ffxx68/Sharp_ce140f_emul/KiCad_v2/Litio_523450.step

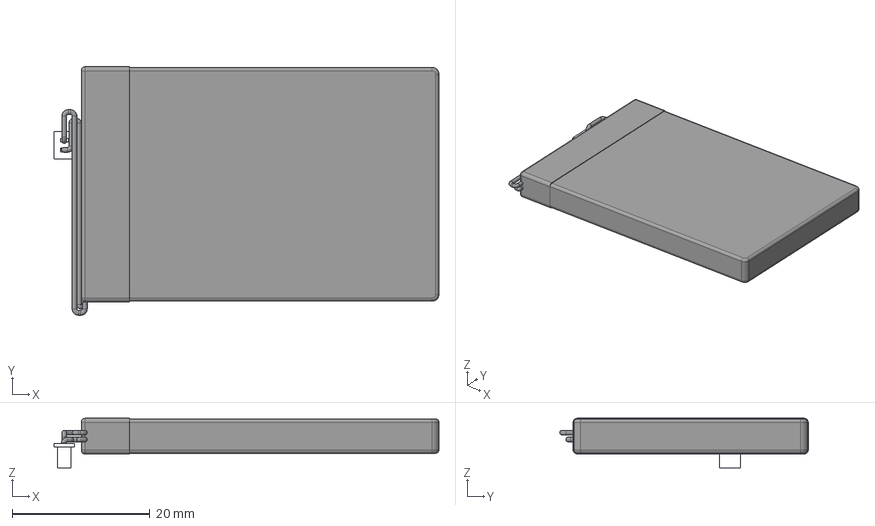
[picture p1: CAD file, 2026-08-25]
KiCad_v2/Litio_523450.step
56.0 x 36.2 x 7.20 mm
Conector
