ffxx68/Sharp_ce140f_emul/KiCad_v2/SD_molex_104031-0811/Molex_104031-0811.stp

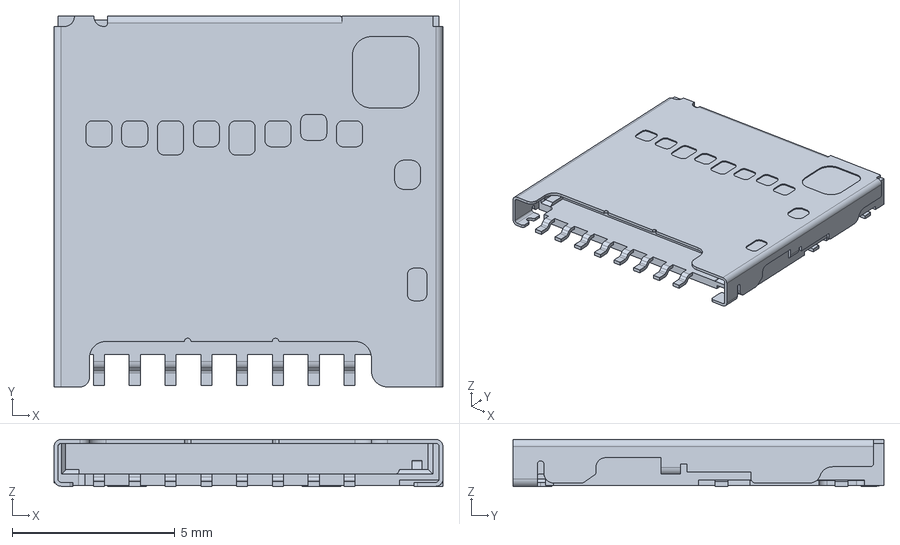
[picture p2: CAD file, 2026-08-25]
KiCad_v2/SD_molex_104031-0811/Molex_104031-0811.stp
11.9 x 11.4 x 1.45 mm
