ffxx68/Sharp_ce140f_emul/KiCad_v1/button/SW_PUSH_6mm.step

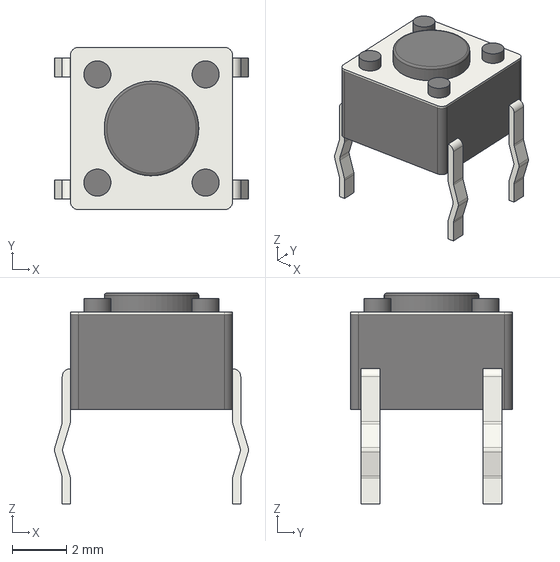
[picture p3: CAD file, 2026-08-25, an earlier design]
KiCad_v1/button/SW_PUSH_6mm.step
7.17 x 6.00 x 7.80 mm
