ffxx68/Sharp_ce140f_emul/(list of files, drawings)

Other design files:
Board_v1.5_PoyokomaDanna/CE-140F_emu11_GP.dip
KiCad_v1/sharp-ce140f-emul_v1.dsn
KiCad_v2/sharp-ce140f-emul_v2.dsn
