ffxx68/Sharp_ce140f_emul/KiCad_v1/sharp-ce140f-emul_v1.kicad_pcb

## KiCad design KiCad_v1/sharp-ce140f-emul_v1.kicad_pcb (2026-08-25, an earlier design)

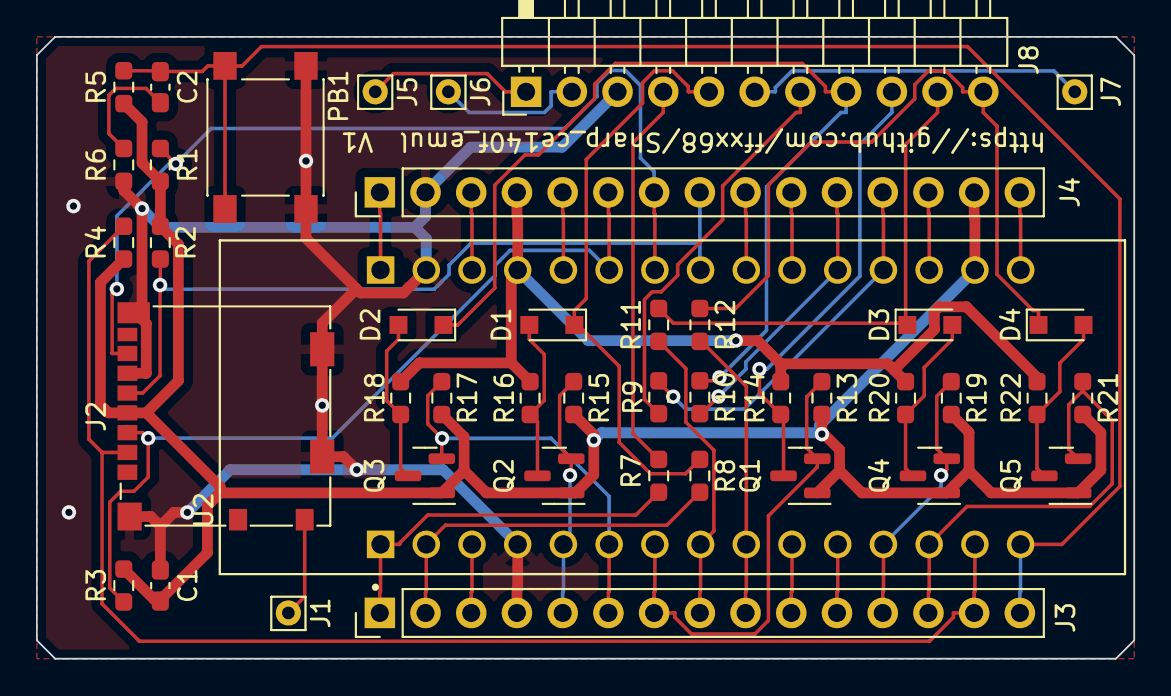
[picture p6: board sharp-ce140f-emul_v1.kicad_pcb from above]

Board: 2 copper layers, 61.0 x 34.5 mm, 43 parts (0 on the bottom side), 45 nets.

Parts:
C1, C2: 100n; C_0603_1608Metric_Pad1.08x0.95mm_HandSolder
D1, D2, D3, D4: 1N4148; D_SOD-323_HandSoldering
J1, J5, J6, J7: Conn_01x01; Pin_D0.7mm_L6.5mm_W1.8mm_FlatFork
J2: Micro_SD_Card_Det; microSD_HC_Molex_104031-0811
J3, J4: Conn_01x15; PinHeader_1x15_P2.54mm_Vertical
J8: Sharp PC 11-pin; PinHeader_1x11_P2.54mm_Horizontal
PB1: User_button; SW_Push_1P1T_NO_6x6mm_H9.5mm
Q1, Q2, Q3, Q4, Q5: BSS138; SOT-23
R1, R2, R3, R4, R5: 47k; R_0603_1608Metric_Pad0.98x0.95mm_HandSolder
R6: 100; R_0603_1608Metric_Pad0.98x0.95mm_HandSolder
R7, R8, R9, R10, R11, R12, R13, R15, R17, R19, R21: 10k; R_0603_1608Metric_Pad0.98x0.95mm_HandSolder
R14, R16, R18, R20, R22: 5k; R_0603_1608Metric_Pad0.98x0.95mm_HandSolder
U2: NUCLEO-L432KC; MODULE_NUCLEO-L432KC

Connections:
+3V3: C1.1, J2.4 (VDD), J4.14, Q1.1 (G), Q2.1 (G), Q3.1 (G), Q4.1 (G), Q5.1 (G), R1.1, R2.1, R3.1, R4.1, R5.2, R13.2, R15.2, R17.2, R19.2, R21.2, U2.CN4_14 (+3V3)
+5V: J4.4, R14.2, R16.2, R18.2, R20.2, R22.2, U2.CN4_4 (+5V)
/Level Conv2/conv_HV: D1.2 (A), Q2.3 (D), R16.1
/Level Conv3/conv_HV: D2.2 (A), Q3.3 (D), R18.1
/Level Conv4/conv_HV: D3.2 (A), Q4.3 (D), R20.1
/Level Conv5/conv_HV: D4.2 (A), Q5.3 (D), R22.1
/conn_ack: J8.9 (ACK), Q1.3 (D), R14.1
/conn_busy: J8.4 (BUSY), R7.1
/conn_din: D2.1 (K), J8.8 (DIN), R10.1
/conn_dout: D1.1 (K), J8.5 (DOUT), R8.1
/conn_mtout2: J5.1, J8.1 (MT_OUT2)
/conn_sel1: D4.1 (K), J8.11 (SEL1), R12.1
/conn_sel2: D3.1 (K), J8.10 (SEL2), R11.1
/conn_vgg: J6.1, J8.2 (VGG)
/conn_xin: J7.1, J8.6 (X_IN)
/conn_xout: J8.7 (X_OUT), R9.1
/rc_btn: C2.2, R6.2
/sd_cd: J1.1, J2.10 (DET_A)
CN3_1: J3.1, R7.2, U2.CN3_1 (PA9)
CN3_2: J3.2, R8.2, U2.CN3_2 (PA10)
CN3_3: J3.3, U2.CN3_3 (NRST_CN3)
CN3_5: J3.5, Q2.2 (S), R15.1, U2.CN3_5 (PA12)
CN3_6: J3.6, Q3.2 (S), R17.1, U2.CN3_6 (PB0)
CN3_7: J3.7, Q1.2 (S), R13.1, U2.CN3_7 (PB7)
CN3_8: J3.8, R11.2, U2.CN3_8 (PB6)
CN3_9: J3.9, R12.2, U2.CN3_9 (PB1)
CN3_10: J3.10, U2.CN3_10 (D7)
CN3_11: J3.11, U2.CN3_11 (D8)
CN3_12: J3.12, Q4.2 (S), R19.1, U2.CN3_12 (PA8)
CN3_13: J3.13, Q5.2 (S), R21.1, U2.CN3_13 (PA11)
CN3_14: J2.2 (DAT3/CD), J3.14, R4.2, U2.CN3_14 (PB5)
CN3_15: C2.1, J3.15, PB1.1, R5.1, U2.CN3_15 (PB4)
CN4_1: J4.1, U2.CN4_1 (VIN)
CN4_3: J4.3, U2.CN4_3 (NRST_CN4)
CN4_5: J4.5, U2.CN4_5 (PA2)
CN4_6: J2.3 (CMD), J4.6, R3.2, U2.CN4_6 (PA7)
CN4_7: J2.7 (DAT0), J4.7, R1.2, U2.CN4_7 (PA6)
CN4_8: J2.5 (CLK), J4.8, R2.2, U2.CN4_8 (PA5)
CN4_9: J4.9, U2.CN4_9 (PA4)
CN4_10: J4.10, U2.CN4_10 (PA3)
CN4_11: J4.11, R10.2, U2.CN4_11 (PA1)
CN4_12: J4.12, R9.2, U2.CN4_12 (PA0)
CN4_13: J4.13, U2.CN4_13 (AREF)
CN4_15: J4.15, U2.CN4_15 (PB3)
GND: C1.2, J2.6 (VSS), J2.11 (SHIELD), J3.4, J4.2, J8.3 (GND), PB1.2, R6.1, U2.CN3_4 (GND_CN3), U2.CN4_2 (GND_CN4)
