ffxx68/Sharp_ce140f_emul/KiCad_v2/sharp-ce140f-emul_v2.kicad_pcb

## KiCad design KiCad_v2/sharp-ce140f-emul_v2.kicad_pcb (2026-08-25)

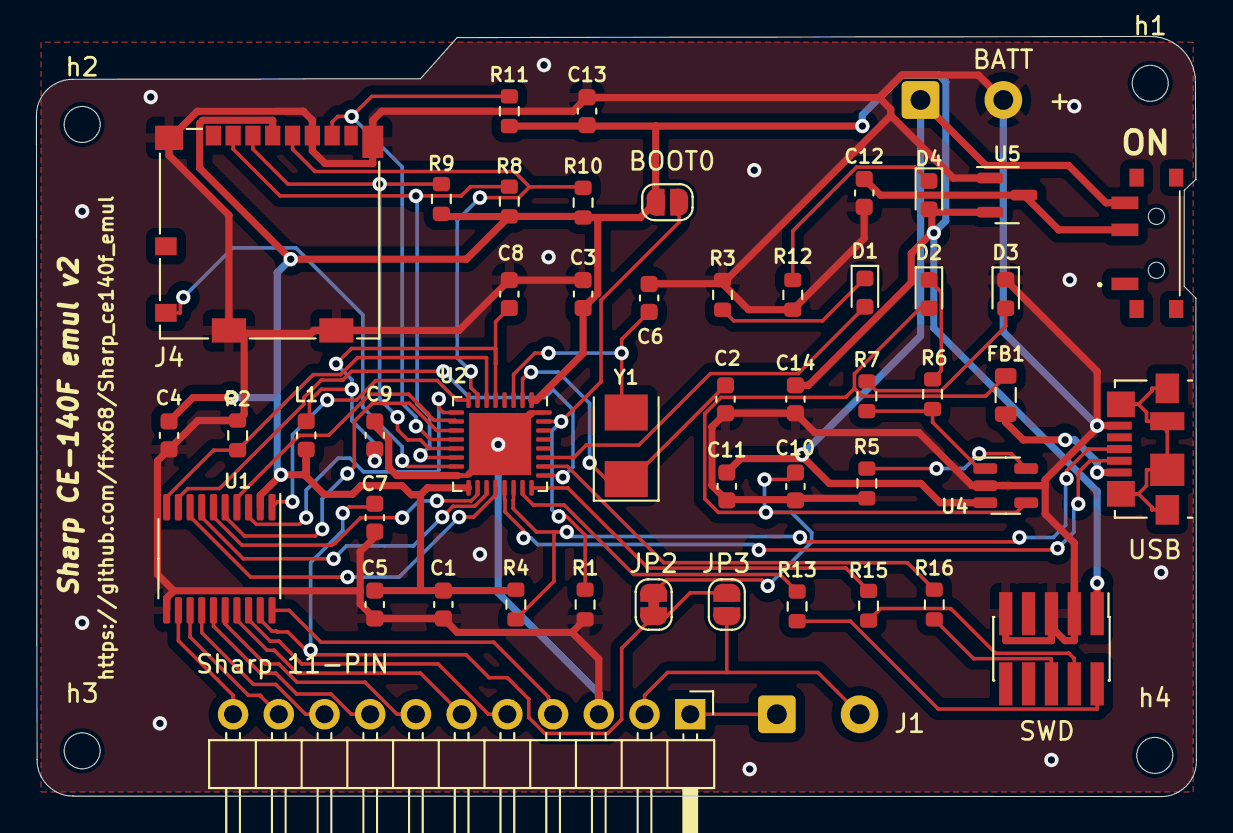
[picture p7: board sharp-ce140f-emul_v2.kicad_pcb from above]

Board: 2 copper layers, 64.4 x 42.2 mm, 54 parts (0 on the bottom side), 50 nets.

Parts:
BATT: Battery; SolderWire-0.5sqmm_1x02_P4.6mm_D0.9mm_OD2.1mm
BOOT0: BOOT0; SolderJumper-2_P1.3mm_Open_RoundedPad1.0x1.5mm
C1, C10, C11: 4u7; C_0603_1608Metric
C2, C6: 10p; C_0603_1608Metric
C3, C4, C5, C7, C9, C13: 100n; C_0603_1608Metric
C8, C12, C14: 1u; C_0603_1608Metric
D1: green; LED_0603_1608Metric
D2, D3: Blue; LED_0603_1608Metric
D4: red; LED_0603_1608Metric
FB1: 100R; L_0805_2012Metric
J1: ext pins; SolderWire-0.5sqmm_1x02_P4.6mm_D0.9mm_OD2.1mm
J4: Micro_SD_Card_Det; microSD_HC_Molex_104031-0811
JP2: 5V_VPP; SolderJumper-2_P1.3mm_Bridged_RoundedPad1.0x1.5mm
JP3: 5V_VGG; SolderJumper-2_P1.3mm_Open_RoundedPad1.0x1.5mm
L1: 27n; L_0603_1608Metric
ON: PCM12SMTR
R1, R5: 10k; R_0603_1608Metric
R2, R3, R4, R12: 1k5; R_0603_1608Metric
R6, R7: 2K2; R_0603_1608Metric
R8, R9, R10, R11: 47k; R_0603_1608Metric
R13, R15, R16: 22; R_0603_1608Metric
SWD: SWD; PinHeader_2x05_P1.27mm_Vertical_SMD
Sharp 11-PIN: Sharp PC 11-pin; PinHeader_1x11_P2.54mm_Horizontal
U1: TXS0108EPW; TSSOP-20_4.4x6.5mm_P0.65mm
U2: STM32L432KCUx; QFN-32-1EP_5x5mm_P0.5mm_EP3.45x3.45mm
U4: MCP73831; SOT-23-5
U5: XC6206P332MR; SOT-23
USB: USB_B_Micro; USB_Micro-B_Molex_47346-0001
Y1: 32.768KHz; Crystal_SMD_5032-2Pin_5.0x3.2mm
h1, h2, h3, h4: MountingHole_2mm

Connections:
+3.3VA: C8.1, C9.1, L1.2, U2.5 (VDDA)
+3V3: BOOT0.2 (B), C1.1, C3.1, C4.1, C5.1, C13.1, C14.1, D4.2 (A), J4.4 (VDD), L1.1, R4.1, R8.1, R9.1, R10.1, R11.1, SWD.1, U1.2 (VCCA), U2.1 (VDD), U2.17 (VDD), U5.2 (VO)
+5V: FB1.2, USB.1 (VBUS)
/BOOT0: BOOT0.1 (A), R1.1, U2.31 (PH3)
/HSE_IN: C2.1, U2.2 (PC14), Y1.1
/HSE_OUT: C6.1, U2.3 (PC15), Y1.2
/V_BAT: BATT.1, C11.1, ON.3 (NO), U4.3 (VBAT)
/ack: Sharp 11-PIN.9 (ACK), U1.14 (B6)
/busy: Sharp 11-PIN.4 (BUSY), U1.20 (B1)
/din: Sharp 11-PIN.8 (DIN), U1.15 (B5)
/dout: Sharp 11-PIN.5 (DOUT), U1.18 (B2)
/mt_out2: J1.1, Sharp 11-PIN.1 (MT_OUT2)
/sel1: Sharp 11-PIN.11 (SEL1), U1.12 (B8)
/sel2: Sharp 11-PIN.10 (SEL2), U1.13 (B7)
/usr_led: D1.2 (A), U2.27 (PB4)
/vccb: C7.1, JP2.1 (A), JP3.1 (A), U1.19 (VCCB)
/vgg: J1.2, JP3.2 (B), Sharp 11-PIN.2 (VGG)
/x_in: Sharp 11-PIN.6 (X_IN), U1.17 (B3)
/x_out: Sharp 11-PIN.7 (X_OUT), U1.16 (B4)
GND: BATT.2, C1.2, C2.2, C3.2, C4.2, C5.2, C6.2, C7.2, C8.2, C9.2, C10.2, C11.2, C12.2, C13.2, C14.2, D3.1 (K), J4.6 (VSS), J4.11 (SHIELD), R1.2, R2.1, R3.2, R5.2, R12.2, SWD.3, SWD.5, SWD.9, Sharp 11-PIN.3 (GND), U1.11 (GND), U2.16 (VSS), U2.32 (VSS), U2.33 (VSS), U4.2 (VSS), U5.1 (GND), USB.5 (GND)
unnamed: D1.1 (K), R3.1
unnamed: D2.1 (K), R6.1
unnamed: D3.2 (A), R7.1
unnamed: D4.1 (K), R12.1
unnamed: R13.2, SWD.2
unnamed: R15.2, SWD.4
unnamed: R16.2, SWD.6
unnamed: R5.1, U4.5 (PROG)
unnamed: R6.2, R7.2, U4.1 (STAT)
PA0: R2.2, U1.10 (OE), U2.6 (PA0)
PA2: U1.1 (A1), U2.8 (PA2)
PA3: U1.3 (A2), U2.9 (PA3)
PA4: U1.4 (A3), U2.10 (PA4)
PA5: U1.5 (A4), U2.11 (PA5)
PA8: U1.6 (A5), U2.18 (PA8)
PA9: U1.7 (A6), U2.19 (PA9)
PA10: U1.8 (A7), U2.20 (PA10)
PA15: U1.9 (A8), U2.25 (PA15)
SD_CD: J4.10 (DET_A), U2.15 (PB1)
SD_CS: J4.2 (DAT3/CD), R8.2, U2.14 (PB0)
SPI1_MISO: J4.7 (DAT0), R11.2, U2.12 (PA6)
SPI1_MOSI: J4.3 (CMD), R9.2, U2.13 (PA7)
SPI1_SCK: J4.5 (CLK), R10.2, U2.7 (PA1)
SWCLK: R15.1, U2.24 (PA14)
SWDIO: R13.1, U2.23 (PA13)
SWO: R16.1, U2.26 (PB3)
USB_D+: R4.2, U2.22 (PA12), USB.3 (D+)
USB_D-: U2.21 (PA11), USB.2 (D-)
VCC: C12.1, ON.2 (COM), U5.3 (VI)
VPP: C10.1, D2.2 (A), FB1.1, JP2.2 (B), U4.4 (VDD)
