ffxx68/Sharp_ce140f_emul/Core/Inc/main.h

#define in_X_OUT_Pin GPIO_PIN_0
#define in_X_OUT_GPIO_Port GPIOA
#define in_D_IN_Pin GPIO_PIN_1
#define in_D_IN_GPIO_Port GPIOA
#define VCP_TX_Pin GPIO_PIN_2
#define VCP_TX_GPIO_Port GPIOA
#define out_D_IN_Pin GPIO_PIN_0
#define out_D_IN_GPIO_Port GPIOB
#define in_SEL_1_Pin GPIO_PIN_1
#define in_SEL_1_GPIO_Port GPIOB
#define out_SEL_2_Pin GPIO_PIN_8
#define out_SEL_2_GPIO_Port GPIOA
#define in_BUSY_Pin GPIO_PIN_9
#define in_BUSY_GPIO_Port GPIOA
#define in_D_OUT_Pin GPIO_PIN_10
#define in_D_OUT_GPIO_Port GPIOA
#define out_SEL_1_Pin GPIO_PIN_11
#define out_SEL_1_GPIO_Port GPIOA
#define out_D_OUT_Pin GPIO_PIN_12
#define out_D_OUT_GPIO_Port GPIOA
#define SWDIO_Pin GPIO_PIN_13
#define SWDIO_GPIO_Port GPIOA
#define SWCLK_Pin GPIO_PIN_14
#define SWCLK_GPIO_Port GPIOA
#define VCP_RX_Pin GPIO_PIN_15
#define VCP_RX_GPIO_Port GPIOA
#define infoLed_Pin GPIO_PIN_3
#define infoLed_GPIO_Port GPIOB
#define user_BTN_Pin GPIO_PIN_4
#define user_BTN_GPIO_Port GPIOB
#define in_SEL_2_Pin GPIO_PIN_6
#define in_SEL_2_GPIO_Port GPIOB
#define out_ACK_Pin GPIO_PIN_7
#define out_ACK_GPIO_Port GPIOB
#define infoLed_Pin GPIO_PIN_3
#define infoLed_GPIO_Port GPIOB
