ffxx68/Sharp_ce140f_emul/Core/Src/main.cpp

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
/* Includes ------------------------------------------------------------------*/
#include "main.h"
#include "fatfs.h"
#include "sd_spi.h"

UART_HandleTypeDef huart2;

void SystemClock_Config(void);
static void MX_GPIO_Init(void);
static void MX_USART2_UART_Init(void);
/* USER CODE BEGIN 0 */
void app_main(void);
/* USER CODE END 0 */

/**
  * @brief  The application entry point.
  * @retval int
  */
int main(void)
{

  /* MCU Configuration--------------------------------------------------------*/

  /* Reset of all peripherals, Initializes the Flash interface and the Systick. */
  HAL_Init();

  /* Configure the system clock */
  SystemClock_Config();

  /* Initialize all configured peripherals */
  MX_GPIO_Init();
  MX_USART2_UART_Init();
  MX_FATFS_Init();
  /* USER CODE BEGIN 2 */

  // SPI1 + CS for the SD card. Must run before the first f_mount(); kept in a
  // USER CODE block so regenerating from the .ioc does not drop it.
  SD_SPI_Init();

  // Link and hand over control to your custom C++ diskette emulator logic
  app_main();

  /* USER CODE END 2 */
}

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
/* USER CODE BEGIN 4 */
extern "C" void HAL_TIM_PeriodElapsedCallback(TIM_HandleTypeDef *htim)
{
  if (htim->Instance == TIM6)
  {
    HAL_IncTick();
  }
}
/* USER CODE END 4 */
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
