ffxx68/Sharp_ce140f_emul/(commit log)

2022-04-22 First version, not tested yet, of an emulator for the Sharp CE-140F Diskette Driver
2022-04-25 revised connector access methods
2022-05-20 changed approach - using interrupts
2022-06-08 Fixed input data handshake
    [main.cpp]
2022-07-29 updated schematics
2022-07-30 fixed output mode pins
    [commands.cpp, main.cpp]
2022-09-22 schematics fix and text editing
2022-09-22 further schematics retouch
2022-09-23 LOAD command changes (though not working yet)
    [commands.cpp]
2022-09-27 SAVE command introduced (not working yet)
    [commands.cpp]
2022-10-21 new prototype version
2022-11-16 Initial upgrade to the L432KC Nucleo board
2022-11-16 Show L432KC prototype
2022-11-20 fixed LOAD 0x0F command (non-ascii files, e.g. BASIC)
    [commands.cpp, commands.h, main.cpp]
2022-11-28 Further fixes (SAVE is still not working...)
    [commands.cpp, commands.h, main.cpp]
2022-12-11 SAVE (binary file, 0xFF command) fixed
    [commands.cpp, main.cpp]
2022-12-22 Reworking of the SAVE command (but ASCII mode 0x16 not working yet)
    [commands.cpp, main.cpp]
2023-01-18 KiCad project added
    [104031-0811.stp, Adafruit MicroUSB Lipo.sch, SW_PUSH_6mm.step, level_converter.kicad_sch, sharp-ce140f-emul_v1.dsn, sharp-ce140f-emul_v1.kicad_pcb, sharp-ce140f-emul_v1.kicad_sch]
2023-01-18 schematics image
2023-01-23 PCB review
    [sharp-ce140f-emul_v1.dsn, sharp-ce140f-emul_v1.kicad_pcb, sharp-ce140f-emul_v1.kicad_sch]
2023-01-23 new PCB version
2023-02-01 some footprint review and BOM exported (csv)
    [sharp-ce140f-emul_v1.csv, sharp-ce140f-emul_v1.dsn, sharp-ce140f-emul_v1.kicad_pcb, sharp-ce140f-emul_v1.kicad_sch]
2023-02-07 Final review before PCB manufacturing
    [Molex_104031-0811.stp, level_converter.kicad_sch, sharp-ce140f-emul_v1.dsn, sharp-ce140f-emul_v1.kicad_pcb, sharp-ce140f-emul_v1.kicad_sch]
2023-03-03 Assembled PCB picture
2023-03-09 PCB version tested on real board
2023-03-22 file OPEN, PRINT#, INPUT# initial implementation
2023-03-23 fixed PRINT# on comma-separated multiple values
    [commands.cpp, main.cpp]
2023-04-27 Changed some delays. Added KILL, OPEN, PRINT#, INPUT#
2023-05-25 Level converter simulation, using KiCad + ngspice
    [Adafruit MicroUSB Lipo.sch, Molex_104031-0811.stp, SW_PUSH_6mm.step, level_conv.kicad_pcb, level_conv.kicad_sch, level_converter.kicad_sch, sharp-ce140f-emul_v1.csv, sharp-ce140f-emul_v1.dsn]
2023-05-25 Fixed simulation design
    [level_conv.kicad_sch]
2023-05-29 Updated KiCad project to latest revision
    [Adafruit MicroUSB Lipo.sch, Molex_104031-0811.stp, SW_PUSH_6mm.step, level_converter.kicad_sch, sharp-ce140f-emul_v1.csv, sharp-ce140f-emul_v1.dsn, sharp-ce140f-emul_v1.kicad_pcb, sharp-ce140f-emul_v1.kicad_sch]
2023-05-30 Updated KiCad project
2023-06-19 new hardware v2 - DRAFT!
    [LevelConv.kicad_sch, Litio_523450.step, sharp-ce140f-emul_v2.dsn, sharp-ce140f-emul_v2.kicad_pcb, sharp-ce140f-emul_v2.kicad_sch]
2023-08-02 New board version (DipTrace and GreenPAK files).
    [CE-140F_emu11_GP.dip]
2023-08-04 Renaming dir
    [CE-140F_emu11_GP.dip]
2023-10-12 DRAFT v2 schematics revisions
    [EDI2CAP.CFG, Molex_104031-0811.stp, PCM12SMTR.PcbLib, PCM12SMTR.SchLib, PCM12SMTR.stp, chips.prt, pcm12smtr.psm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]
2023-11-28 Fix to PRINT# and INPUT# processing
    [commands.cpp, commands.h]
2023-11-28 removing unecessary files
    [EDI2CAP.CFG, PCM12SMTR.PcbLib, PCM12SMTR.SchLib, PCM12SMTR.stp, chips.prt, pcm12smtr.psm]
2024-08-26 PCBWay and editing
2024-12-02 trying to fix INPUT for number arrays
    [commands.cpp, main.cpp]
2026-08-25 Migrate Sharp CE-140F emulator layout from legacy Mbed to native STM32Cube HAL framework including IDE configurations
2026-08-26 debugging Issue #10 - DSKF Error
    [app_main.cpp, main.cpp]
2026-09-01 Still debugging issue #10
    [app_main.cpp, commands.cpp, commands.h, main.cpp]
2026-09-01 pin testing commands
2026-09-02 Fixed DSKF 2 communication issue #10
    [app_main.cpp]
2026-09-03 Fixed issue #12 SD card access
    [user_diskio.c]
2026-09-03 Fixed LOAD issue #13
    [app_main.cpp, commands.cpp]
2026-09-04 Fix issue #15 protocol documentation
    [commands.cpp]
2026-09-04 fixing issue #14 SAVE error
    [app_main.cpp, commands.cpp, user_diskio.c]
2026-09-23 manual merge of phoen1s' improvements - BUILD ERROR to fix
    [app_main.cpp, commands.cpp, commands.h, main.cpp, sd_spi.c, sd_spi.h, user_diskio.c]
2026-09-23 BUILD ERROR to be fixed
    [app_main.cpp]
2026-09-23 Fixed build error - TO BE TESTED on real device
    [commands.h]
